saulrh/pcimotor/README.md

pcimotor
========

Microcontroller and driver code for a modular motor controller. The interesting thing is that this controller will fit into a PCI slot, so you can either plug it directly into your computer or into a special USB-interface backplane that we're also developing.
