saulrh/pcimotor/boards/daughterboard/pcie_board.brd

## EAGLE design boards/daughterboard/pcie_board.brd (2012-05-04)

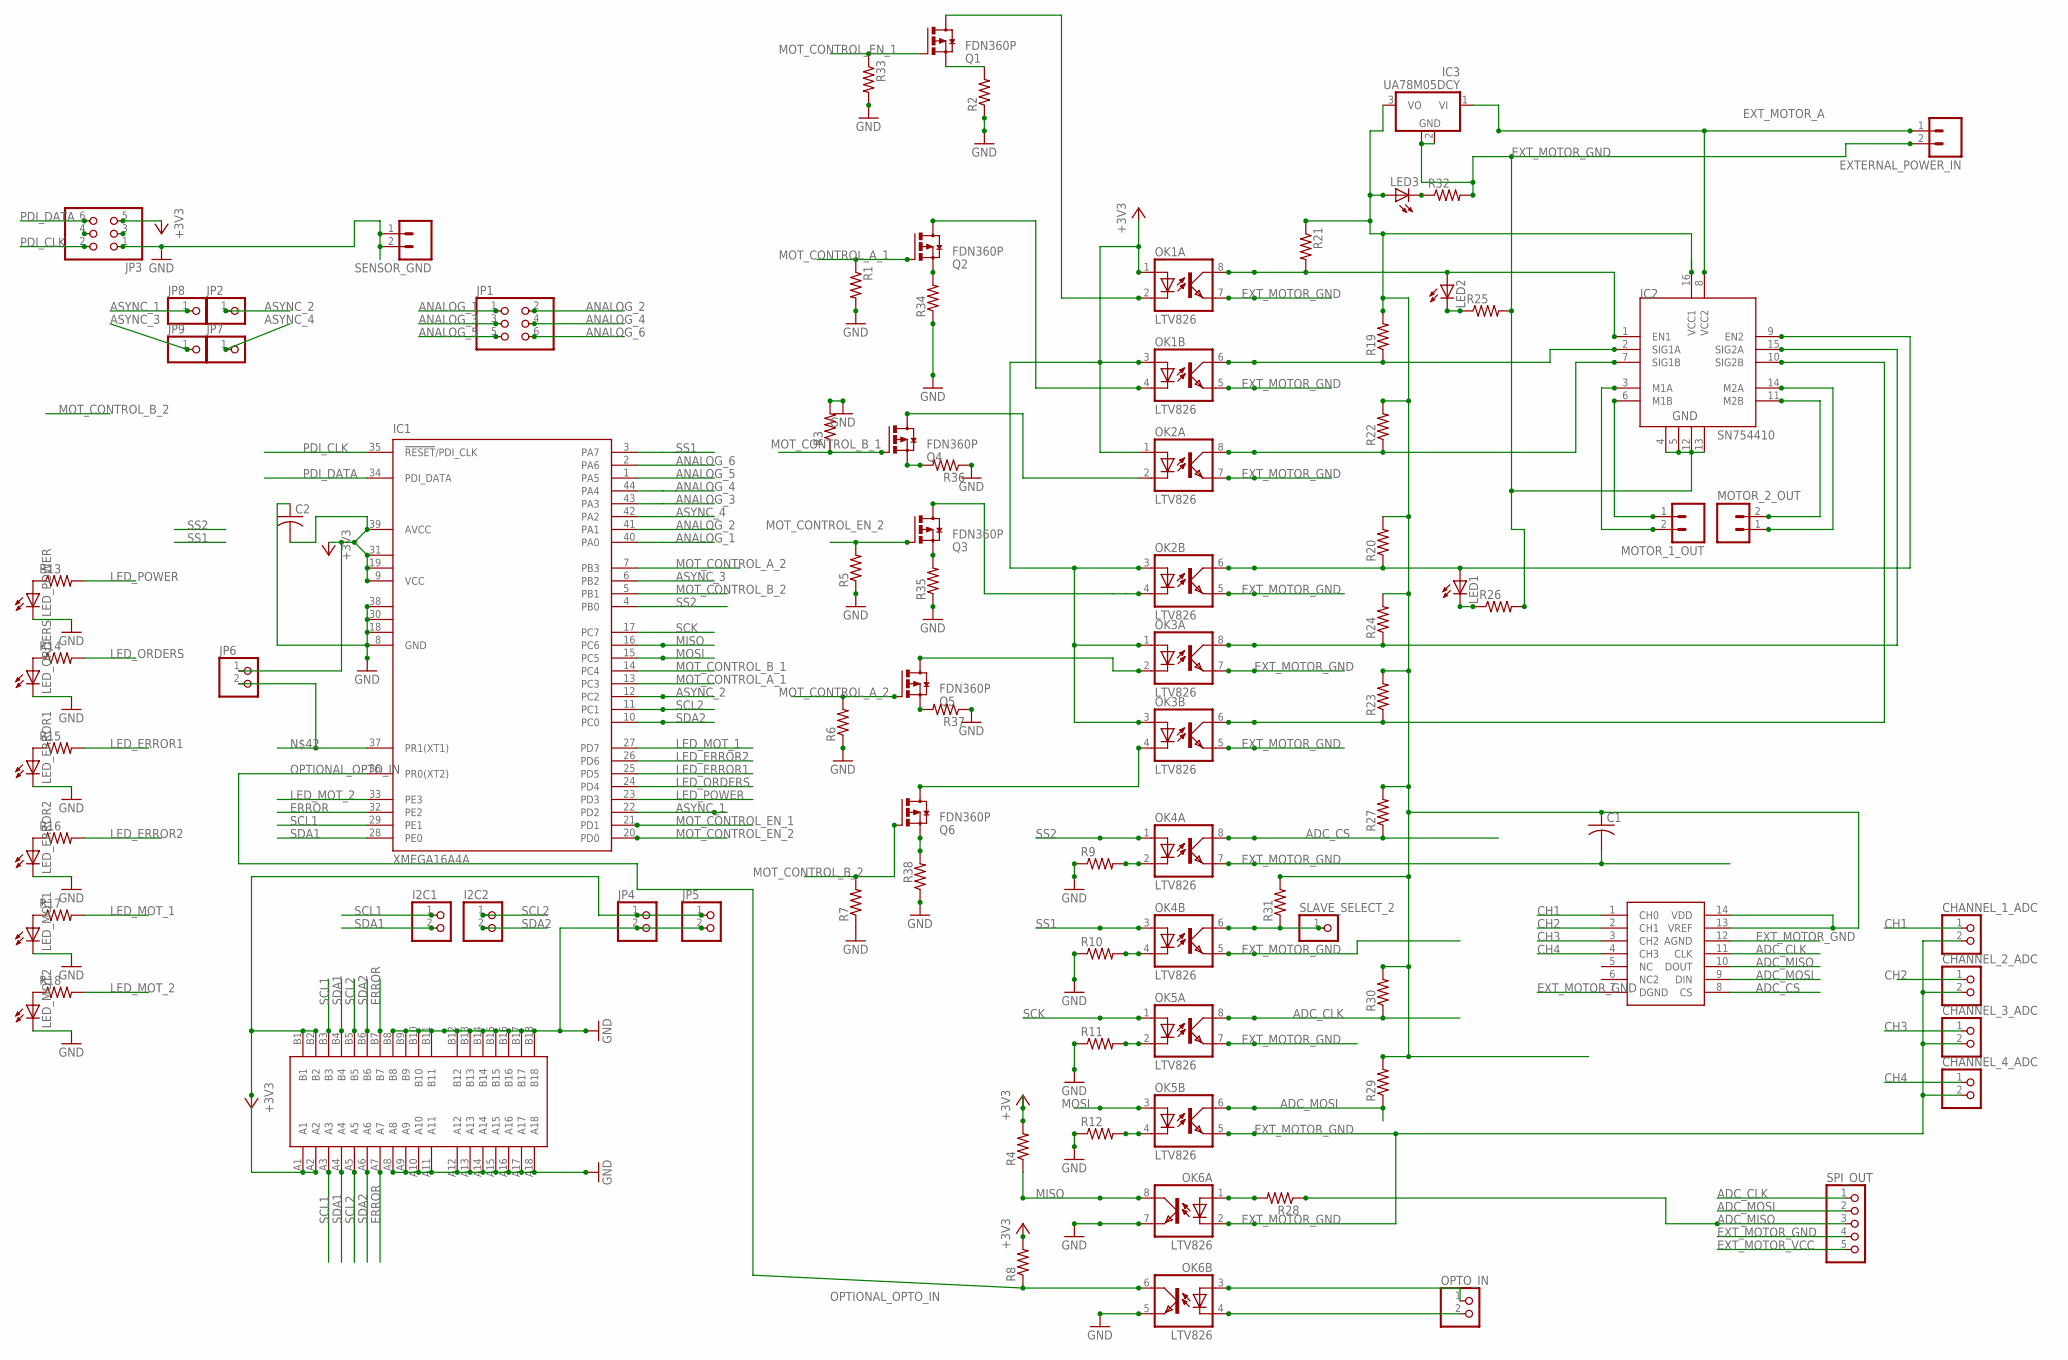
[picture p1: schematic pcie_board.sch, sheet 1]

Parts:
C1, C2: C-US025-040X050; C025-040X050
CHANNEL_1_ADC, CHANNEL_2_ADC, CHANNEL_3_ADC, CHANNEL_4_ADC: PINHD-1X2; 1X02
EXTERNAL_POWER_IN: M023.5MM; SCREWTERMINAL-3.5MM-2
I2C1, I2C2: PINHD-1X2; 1X02
IC1: XMEGA16A4A; TQFP44
IC2: SN754410; DIP16
IC3: UA78M05DCY; SOT223
JP1, JP3: PINHD-2X3; 2X03
JP2, JP7, JP8, JP9: PINHD-1X1; 1X01
JP4, JP5, JP6: PINHD-1X2; 1X02
LED1, LED2, LED3: LEDCHIP-LED0603; CHIP-LED0603
LED_ERROR1, LED_ERROR2: LED5MM
LED_MOT1, LED_MOT2: LED5MM
LED_ORDERS: LED5MM
LED_POWER: LED5MM
MOTOR_1_OUT, MOTOR_2_OUT: M023.5MM; SCREWTERMINAL-3.5MM-2
OK1, OK2, OK3, OK4, OK5, OK6: LTV826; DIL08
OPTO_IN: PINHD-1X2; 1X02
Q1, Q2, Q3, Q4, Q5, Q6: FDN360P; SUPER-SOT3
R1, R2, R3, R4, R5, R6, R7, R8, R9, R10, R11, R12, R13, R14, R15, R16, R17, R18, R19, R20, R21, R22, R23, R24, R25, R26, R27, R28, R29, R30, R31, R32, R33, R34, R35, R36, R37, R38: R-US_M0805; M0805
SENSOR_GND: M023.5MM; SCREWTERMINAL-3.5MM-2
SLAVE_SELECT_2: PINHD-1X1; 1X01
SPI_OUT: PINHD-1X5; 1X05
U$1: PCI-E1X_EDGE; PCI-E_X1_EDGE
U$2: MCP3004; DIL14

Connections:
+3V3: C2.2, IC1.9 (VCC), IC1.19 (VCC1), IC1.31 (VCC2), IC1.39 (AVCC), JP3.5, JP4.1, JP5.1, JP6.1, OK1.1 (A), OK1.3 (A), OK2.1 (A), OK2.3 (A), OK3.1 (A), OK3.3 (A), R4.2, R8.2, U$1.A1, U$1.A2, U$1.B1, U$1.B2
ADC_CLK: OK5.8 (COL), R30.1, SPI_OUT.1, U$2.11 (CLK)
ADC_CS: OK4.8 (COL), R27.1, U$2.8 (CS)
ADC_MISO: R28.1, SPI_OUT.3, U$2.10 (DOUT)
ADC_MOSI: OK5.6 (COL), R29.1, SPI_OUT.2, U$2.9 (DIN)
ANALOG_1: IC1.40 (PA0), JP1.1
ANALOG_2: IC1.41 (PA1), JP1.2
ANALOG_3: IC1.43 (PA3), JP1.3
ANALOG_4: IC1.44 (PA4), JP1.4
ANALOG_5: IC1.1 (PA5), JP1.5
ANALOG_6: IC1.2 (PA6), JP1.6
ASYNC_1: IC1.22 (PD2), JP8.1
ASYNC_2: IC1.12 (PC2), JP2.1
ASYNC_3: IC1.6 (PB2), JP9.1
ASYNC_4: IC1.42 (PA2), JP7.1
CH1: CHANNEL_1_ADC.1, U$2.1 (CH0)
CH2: CHANNEL_2_ADC.1, U$2.2 (CH1)
CH3: CHANNEL_3_ADC.1, U$2.3 (CH2)
CH4: CHANNEL_4_ADC.1, U$2.4 (CH3)
ERROR: IC1.32 (PE2), U$1.A7, U$1.B7
EXT_MOTOR_A: EXTERNAL_POWER_IN.1, IC2.8 (VCC2), IC3.1 (VI)
EXT_MOTOR_GND: C1.2, CHANNEL_1_ADC.2, CHANNEL_2_ADC.2, CHANNEL_3_ADC.2, CHANNEL_4_ADC.2, EXTERNAL_POWER_IN.2, IC2.4, IC2.5, IC2.12, IC2.13, IC3.2 (GND), IC3.4 (GND), OK1.5 (EMIT), OK1.7 (EMIT), OK2.5 (EMIT), OK2.7 (EMIT), OK3.5 (EMIT), OK3.7 (EMIT), OK4.5 (EMIT), OK4.7 (EMIT), OK5.5 (EMIT), OK5.7 (EMIT), OK6.2 (C), R25.2, R26.2, R32.2, SPI_OUT.4, U$2.7 (DGND), U$2.12 (AGND)
EXT_MOTOR_VCC: C1.1, IC2.16 (VCC1), IC3.3 (VO), LED3.A, R19.2, R20.2, R21.1, R22.2, R23.2, R24.2, R27.2, R29.2, R30.2, R31.2, SPI_OUT.5, U$2.13 (VREF), U$2.14 (VDD)
GND: C2.1, IC1.8 (GND), IC1.18 (GND1), IC1.30 (GND2), IC1.38 (GND3), JP3.1, JP4.2, JP5.2, LED_ERROR1.K (C), LED_ERROR2.K (C), LED_MOT1.K (C), LED_MOT2.K (C), LED_ORDERS.K (C), LED_POWER.K (C), OK6.5 (EMIT), OK6.7 (EMIT), R1.2, R2.1, R3.2, R5.1, R6.1, R7.1, R9.1, R10.1, R11.1, R12.1, R33.2, R34.1, R35.1, R36.1, R37.1, R38.1, SENSOR_GND.1, SENSOR_GND.2, U$1.A8, U$1.A9, U$1.A10, U$1.A11, U$1.A12, U$1.A13, U$1.A14, U$1.A15, U$1.A16, U$1.A17, U$1.A18, U$1.B8, U$1.B9, U$1.B10, U$1.B11, U$1.B12, U$1.B13, U$1.B14, U$1.B15, U$1.B16, U$1.B17, U$1.B18
LED_ERROR1: IC1.25 (PD5), R15.2
LED_ERROR2: IC1.26 (PD6), R16.2
LED_MOT_1: IC1.27 (PD7), R17.2
LED_MOT_2: IC1.33 (PE3), R18.2
LED_ORDERS: IC1.24 (PD4), R14.2
LED_POWER: IC1.23 (PD3), R13.2
MISO: IC1.16 (PC6), OK6.8 (COL), R4.1
MOSI: IC1.15 (PC5), OK5.3 (A)
MOT_CONTROL_A_1: IC1.13 (PC3), Q2.1 (G), R1.1
MOT_CONTROL_A_2: IC1.7 (PB3), Q5.1 (G), R6.2
MOT_CONTROL_B_1: IC1.14 (PC4), Q4.1 (G), R3.1
MOT_CONTROL_B_2: IC1.5 (PB1), Q6.1 (G), R7.2
MOT_CONTROL_EN_1: IC1.21 (PD1), Q1.1 (G), R33.1
MOT_CONTROL_EN_2: IC1.20 (PD0), Q3.1 (G), R5.2
unnamed: IC2.14 (M2A), MOTOR_2_OUT.1
unnamed: Q1.2 (S), R2.2
unnamed: IC2.11 (M2B), MOTOR_2_OUT.2
unnamed: OK1.2 (C), Q1.3 (D)
unnamed: Q2.2 (S), R34.2
unnamed: OK1.4 (C), Q2.3 (D)
unnamed: Q4.2 (S), R36.2
unnamed: OK4.2 (C), R9.2
unnamed: OK2.4 (C), Q3.3 (D)
unnamed: OK3.2 (C), Q5.3 (D)
unnamed: Q5.2 (S), R37.2
unnamed: OK4.4 (C), R10.2
unnamed: OK5.2 (C), R11.2
unnamed: OK5.4 (C), R12.2
unnamed: Q3.2 (S), R35.2
unnamed: LED_POWER.A, R13.1
unnamed: LED_ORDERS.A, R14.1
unnamed: OK2.2 (C), Q4.3 (D)
unnamed: OK4.6 (COL), R31.1, SLAVE_SELECT_2.1
unnamed: LED_ERROR1.A, R15.1
unnamed: LED_ERROR2.A, R16.1
unnamed: LED_MOT1.A, R17.1
unnamed: LED_MOT2.A, R18.1
unnamed: IC2.1 (EN1), LED2.A, OK1.8 (COL), R21.2
unnamed: IC2.2 (SIG1A), OK1.6 (COL), R19.1
unnamed: LED2.C, R25.1
unnamed: LED1.C, R26.1
unnamed: IC2.9 (EN2), LED1.A, OK2.6 (COL), R20.1
unnamed: IC2.7 (SIG1B), OK2.8 (COL), R22.1
unnamed: IC2.15 (SIG2A), OK3.8 (COL), R24.1
unnamed: IC2.3 (M1A), MOTOR_1_OUT.2
unnamed: IC2.6 (M1B), MOTOR_1_OUT.1
unnamed: IC2.10 (SIG2B), OK3.6 (COL), R23.1
unnamed: OK6.1 (A), R28.2
unnamed: OK6.3 (A), OPTO_IN.1
unnamed: OK6.4 (C), OPTO_IN.2
unnamed: LED3.C, R32.1
unnamed: Q6.2 (S), R38.2
unnamed: OK3.4 (C), Q6.3 (D)
unnamed: IC1.37 (PR1(XT1)), JP6.2
OPTIONAL_OPTO_IN: IC1.36 (PR0(XT2)), OK6.6 (COL), R8.1
PDI_CLK: IC1.35 (!RESET!/PDI_CLK), JP3.2
PDI_DATA: IC1.34 (PDI_DATA), JP3.6
SCK: IC1.17 (PC7), OK5.1 (A)
SCL1: I2C1.1, IC1.29 (PE1), U$1.A3, U$1.B3
SCL2: I2C2.1, IC1.11 (PC1), U$1.A5, U$1.B5
SDA1: I2C1.2, IC1.28 (PE0), U$1.A4, U$1.B4
SDA2: I2C2.2, IC1.10 (PC0), U$1.A6, U$1.B6
SS1: IC1.3 (PA7), OK4.3 (A)
SS2: IC1.4 (PB0), OK4.1 (A)

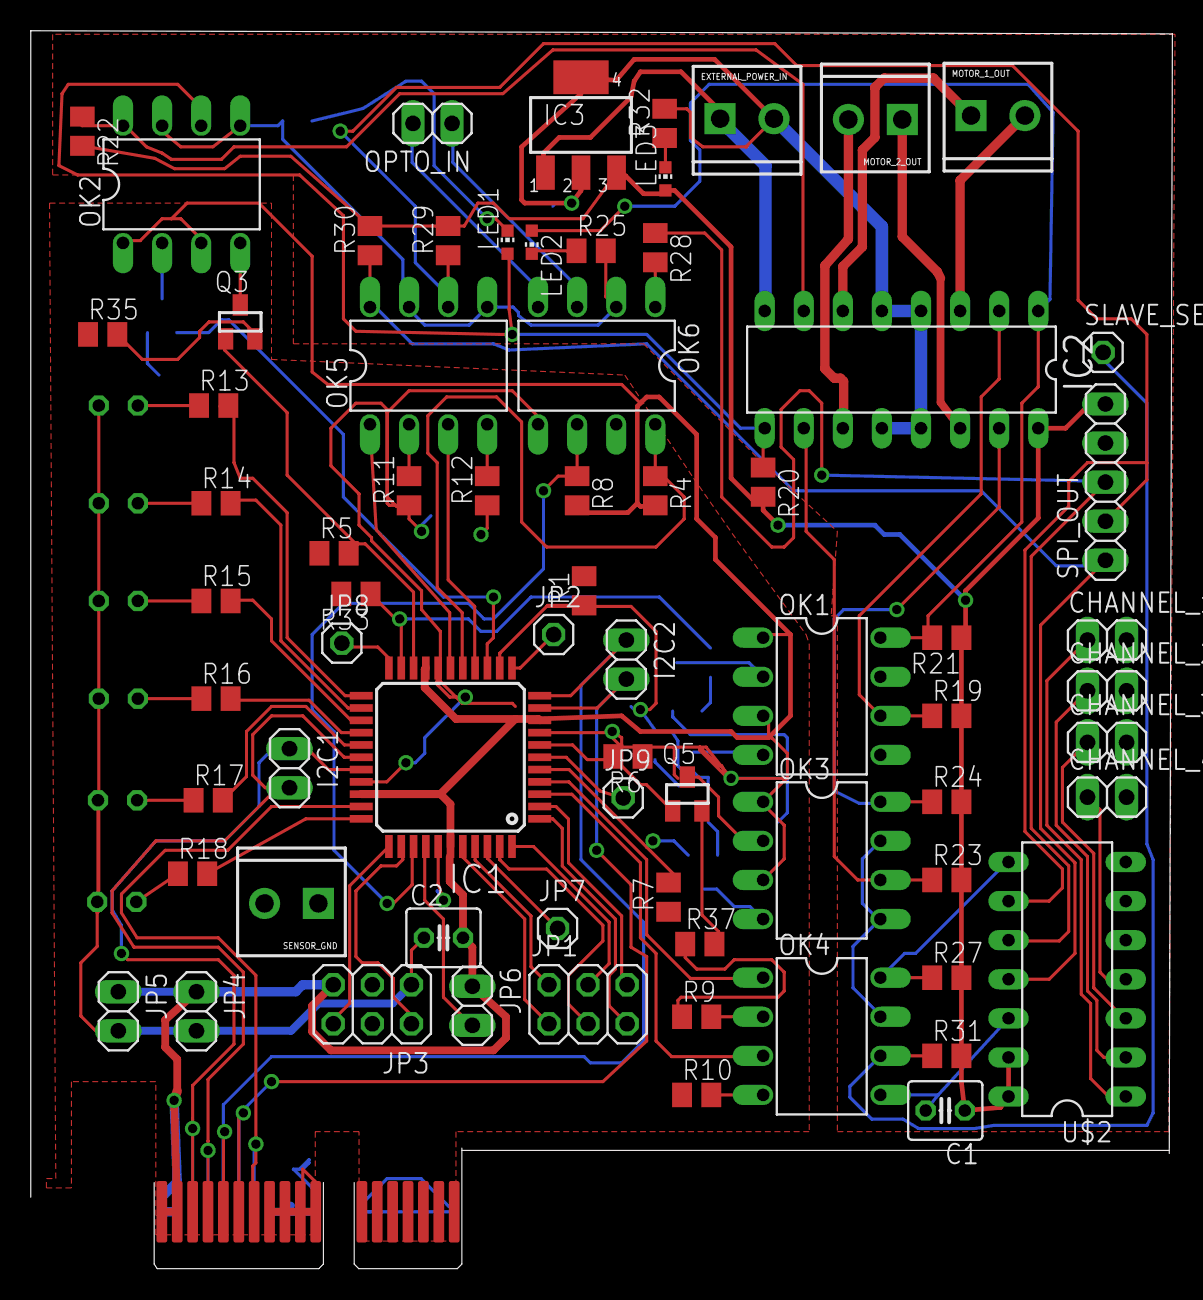
[picture p2: board pcie_board.brd from above]

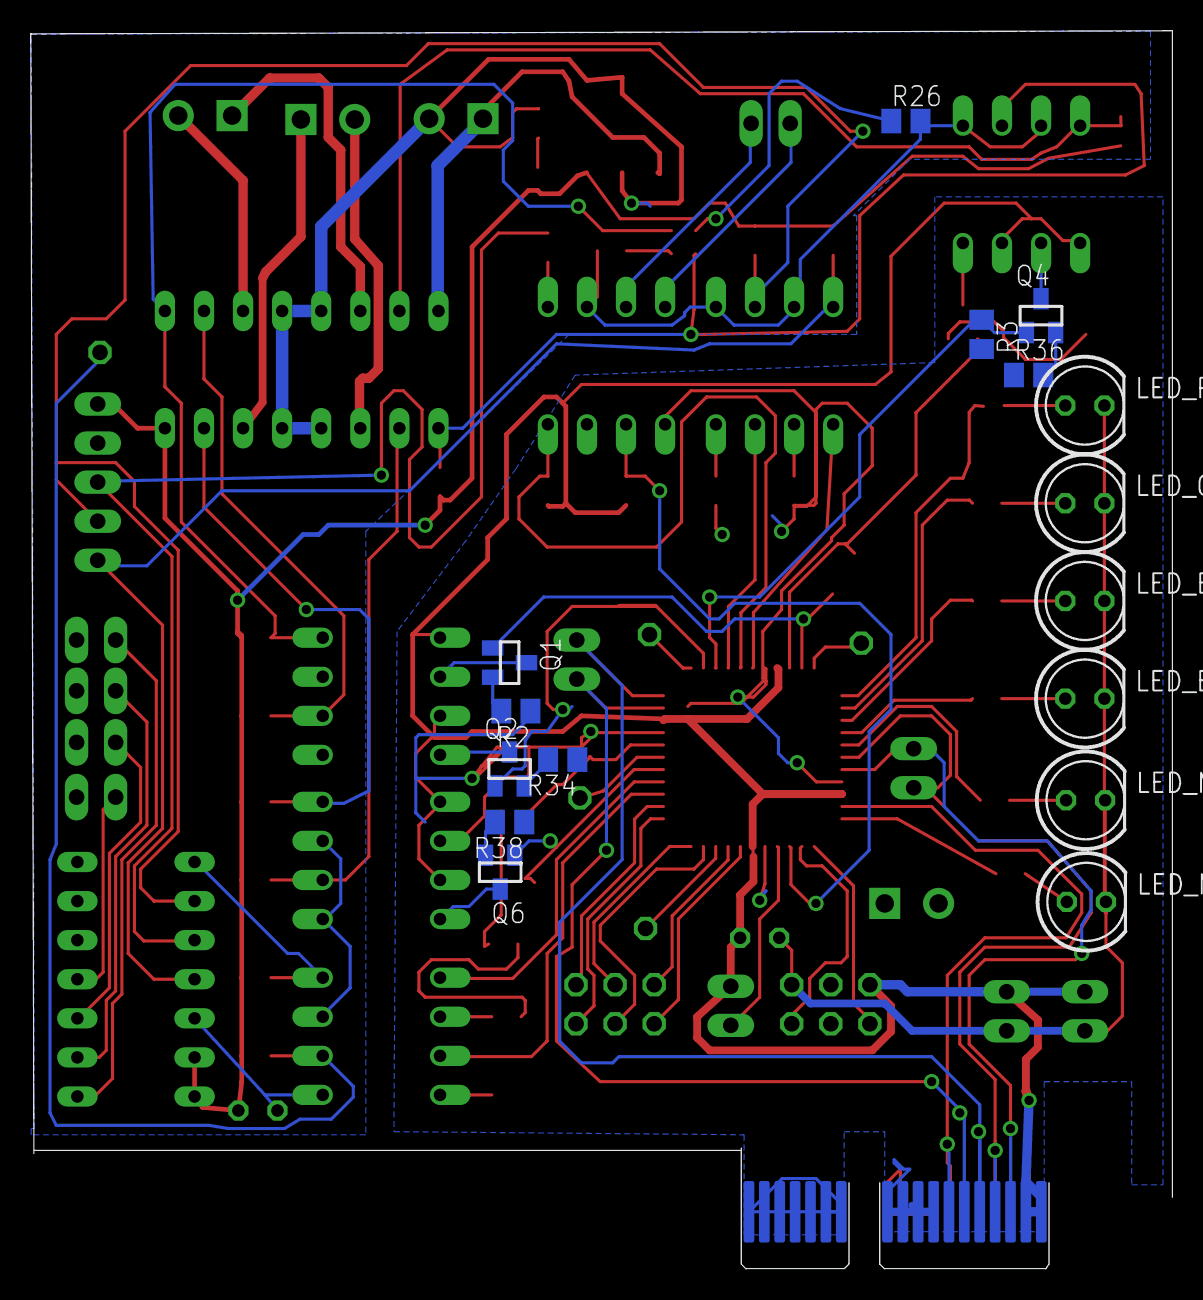
[picture p3: board pcie_board.brd from below]

Board: 2 copper layers, 74.2 x 80.5 mm, 88 parts (16 on the bottom side), 88 nets.
