saulrh/pcimotor/boards/motherboard/motherboard.brd

## EAGLE design boards/motherboard/motherboard.brd (2012-04-24)

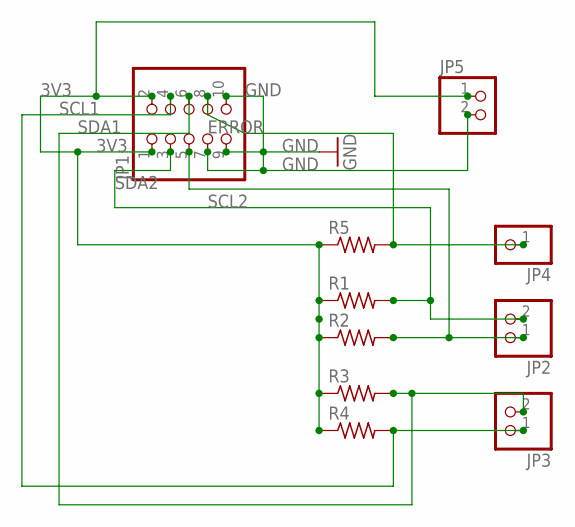
[picture p4: schematic motherboard.sch]

Parts:
JP1: PINHD-2X5; 2X05
JP2, JP3, JP5: PINHD-1X2; 1X02
JP4: PINHD-1X1; 1X01
R1, R2, R3, R4, R5: R-US_M0805; M0805

Connections:
3V3: JP1.1, JP1.2, JP5.1, R1.1, R2.1, R3.1, R4.1, R5.1
ERROR: JP1.8, JP4.1, R5.2
GND: JP1.7, JP1.9, JP1.10, JP5.2
SCL1: JP1.4, JP3.1, R4.2
SCL2: JP1.5, JP2.1, R2.2
SDA1: JP1.6, JP3.2, R3.2
SDA2: JP1.3, JP2.2, R1.2

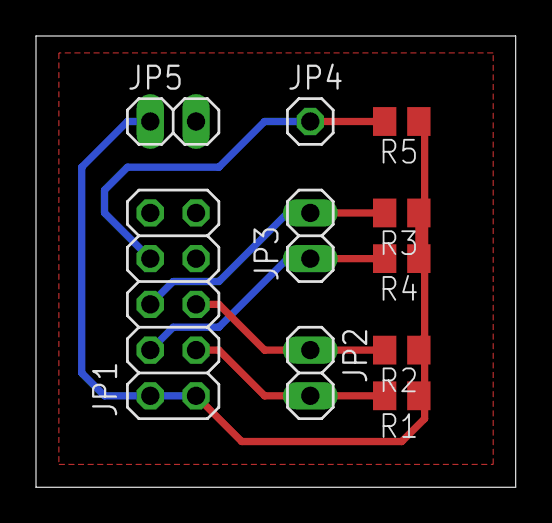
[picture p5: board motherboard.brd from above]

Board: 2 copper layers, 26.7 x 25.1 mm, 10 parts (0 on the bottom side), 7 nets.
