saulrh/pcimotor/boards/satellite_board/satellite.brd

## EAGLE design boards/satellite_board/satellite.brd (2012-04-24)

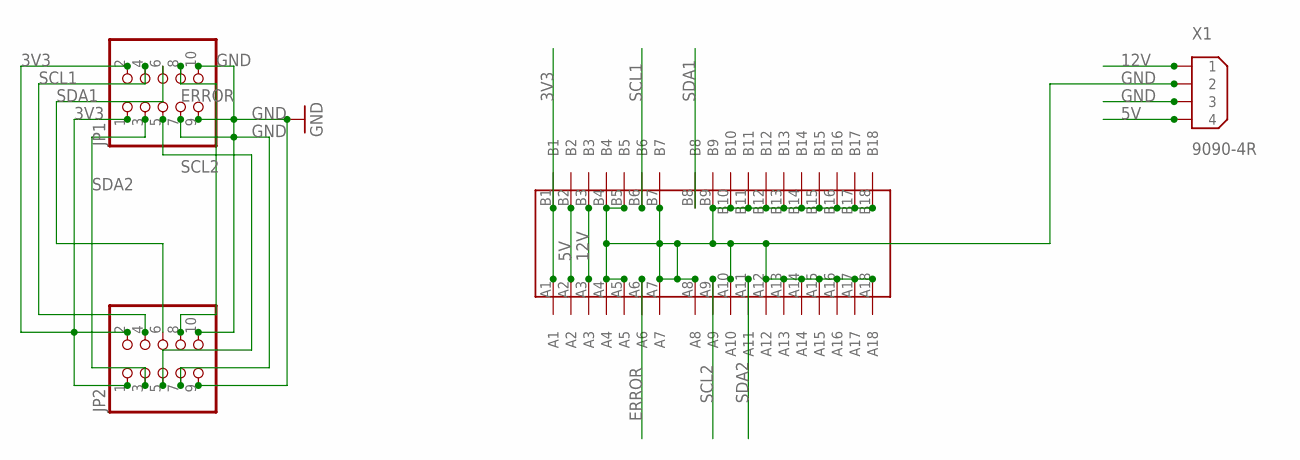
[picture p6: schematic satellite.sch]

Parts:
JP1, JP2: PINHD-2X5; 2X05
U$1: PCIE1X
X1: 9090-4R

Connections:
3V3: JP1.1, JP1.2, JP2.1, JP2.2, U$1.A1, U$1.B1
5V: U$1.A2, U$1.B2, X1.4
12V: U$1.A3, U$1.B3, X1.1
ERROR: JP1.8, JP2.8, U$1.A6
GND: JP1.7, JP1.9, JP1.10, JP2.7, JP2.9, JP2.10, U$1.A4, U$1.A5, U$1.A7, U$1.A8, U$1.A10, U$1.A12, U$1.A13, U$1.A14, U$1.A15, U$1.A16, U$1.A17, U$1.A18, U$1.B4, U$1.B5, U$1.B7, U$1.B9, U$1.B10, U$1.B11, U$1.B12, U$1.B13, U$1.B14, U$1.B15, U$1.B16, U$1.B17, U$1.B18, X1.2, X1.3
SCL1: JP1.4, JP2.4, U$1.B6
SCL2: JP1.5, JP2.5, U$1.A9
SDA1: JP1.6, JP2.6, U$1.B8
SDA2: JP1.3, JP2.3, U$1.A11

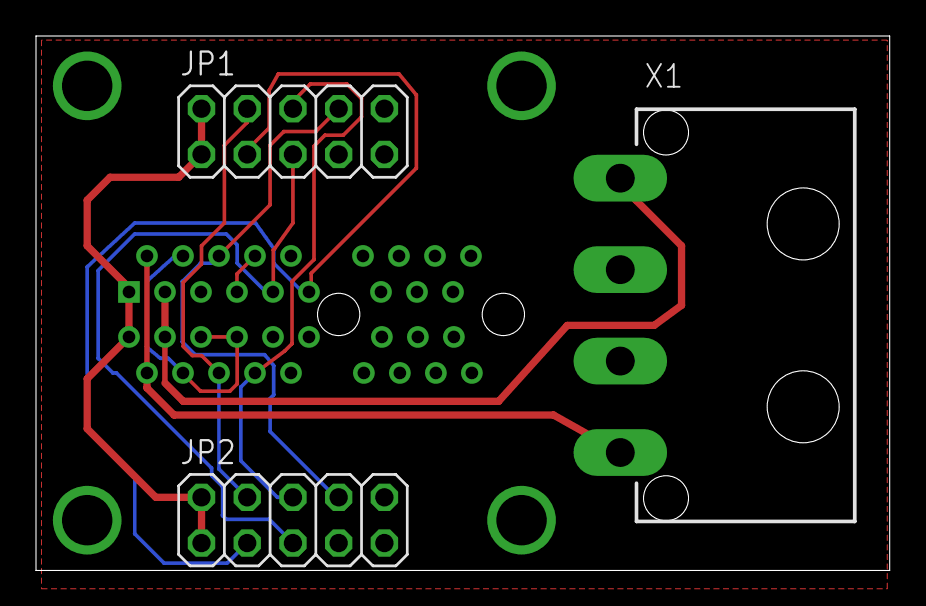
[picture p7: board satellite.brd from above]

Board: 2 copper layers, 47.4 x 29.7 mm, 4 parts (0 on the bottom side), 9 nets.
