saulrh/pcimotor/avr/avr_compiler.h

/* This file has been prepared for Doxygen automatic documentation generation.*/
/*! \file *********************************************************************
 *
 * \brief This file implements some macros that makes the IAR C-compiler and
 *        avr-gcc work with the same code base for the AVR architecture.
 *
 * \par Documentation
 *      For comprehensive code documentation, supported compilers, compiler
 *      settings and supported devices see readme.html
 *
 * \author
 *      Atmel Corporation: http://www.atmel.com \n
 *      Support email: avr@atmel.com
 *
 * $Revision: 2772 $
 * $Date: 2009-09-11 12:40:26 +0200 (fr, 11 sep 2009) $  \n
 *
 * Copyright (c) 2008, Atmel Corporation All rights reserved.
 *
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
 * 3. The name of ATMEL may not be used to endorse or promote products derived
 * from this software without specific prior written permission.
 *
 * THIS SOFTWARE IS PROVIDED BY ATMEL "AS IS" AND ANY EXPRESS OR IMPLIED
 * WARRANTIES, INCLUDING, BUT NOT LIMITED TO, THE IMPLIED WARRANTIES OF
 * MERCHANTABILITY AND FITNESS FOR A PARTICULAR PURPOSE ARE EXPRESSLY AND
 * SPECIFICALLY DISCLAIMED. IN NO EVENT SHALL ATMEL BE LIABLE FOR ANY DIRECT,
 * INDIRECT, INCIDENTAL, SPECIAL, EXEMPLARY, OR CONSEQUENTIAL DAMAGES
 * (INCLUDING, BUT NOT LIMITED TO, PROCUREMENT OF SUBSTITUTE GOODS OR SERVICES;
 * LOSS OF USE, DATA, OR PROFITS; OR BUSINESS INTERRUPTION) HOWEVER CAUSED AND
 * ON ANY THEORY OF LIABILITY, WHETHER IN CONTRACT, STRICT LIABILITY, OR TORT
 * (INCLUDING NEGLIGENCE OR OTHERWISE) ARISING IN ANY WAY OUT OF THE USE OF
 * THIS SOFTWARE, EVEN IF ADVISED OF THE POSSIBILITY OF SUCH DAMAGE.
 ******************************************************************************/

#ifndef COMPILER_AVR_H
#define COMPILER_AVR_H

#ifndef F_CPU
/*! \brief Define default CPU frequency, if this is not already defined. */
#define F_CPU 2000000UL
#endif

#include <stdint.h>
#include <stdbool.h>
#include <stdlib.h>

/*! \brief This macro will protect the following code from interrupts. */
#define AVR_ENTER_CRITICAL_REGION( ) uint8_t volatile saved_sreg = SREG; \
                                     cli();

/*! \brief This macro must always be used in conjunction with AVR_ENTER_CRITICAL_REGION
 *        so the interrupts are enabled again.
 */
#define AVR_LEAVE_CRITICAL_REGION( ) SREG = saved_sreg;






#include <avr/io.h>
#include <avr/interrupt.h>
#include <avr/pgmspace.h>
#include <util/delay.h>

/*! \brief Define the delay_us macro for GCC. */
#define delay_us( us )   (_delay_us( us ))

#define INLINE static inline

/*! \brief Define the no operation macro. */
#define nop()   do { __asm__ __volatile__ ("nop"); } while (0)

#define MAIN_TASK_PROLOGUE int


#define MAIN_TASK_EPILOGUE() return -1;

#define SHORTENUM __attribute__ ((packed))

#endif
