saulrh/pcimotor/(commit log)

2012-04-16 Accidentally left a hanging define. fixed.
    [daughterboard.c]
2012-04-20 make the LEDs flash faster
2012-04-20 Add daughterboard.h for function prototypes
2012-04-21 fixed bug in pin definitions
    [daughterboard.h]
2012-04-21 use symbolic pin name declarations and multipin config
2012-04-21 display received twi data on leds
2012-04-21 change to I2C interface 2
2012-04-21 start up summary of i2c command protocol
2012-04-23 Fixed includes in daughterboard.c for movements.
    [daughterboard.c]
2012-04-23 New code for handling LEDs
2012-04-23 Rough draft of I2C interface
2012-04-23 daughterboard.h: Fixed typedefs for sensor_t
    [daughterboard.h]
2012-04-23 Reorganize so we can add drivers and boards later
2012-04-23 added the board design files
    [board_with_sense.brd, board_with_sense.sch]
2012-04-23 reorganized the boards into folders
    [board_with_sense.brd, board_with_sense.sch]
2012-04-23 Removed duplicate files. Use tags for marking revs
    [board_with_sense.brd, board_with_sense.sch]
2012-04-24 moved stuff around to allow for more boards
    [pcie_board.brd, pcie_board.sch]
2012-04-24 added the eagle libraries, as well as the satellite board
    [satellite.brd, satellite.sch]
2012-04-24 added the interface board to talk to the ribbon cable of the satellite board
    [satellite_interface.brd, satellite_interface.sch]
2012-04-24 Rename boards to standardized names
    [motherboard.brd, motherboard.sch, pcie_board.brd, pcie_board.sch]
2012-04-27 daughterboard: Define structs for motors and controller
2012-04-27 daughterboard: start changing over to hardware pwm
2012-04-28 fixed the timer from port C to port D
    [daughterboard.c]
2012-04-28 fixing random bugs - working toward motor pwm
    [daughterboard.c]
2012-04-28 Add driver for watchdog timer
2012-04-28 Link in code for watchdog timer
2012-04-28 daughterboard.h: Fix definitions for digital pins
    [daughterboard.h]
2012-04-28 daughterboard.c: include watchdog timer
2012-04-28 daughterboard.c: set and handle watchdog timer
2012-04-28 Start changing LEDs over to malloc's structs
2012-04-28 Finish converting leds to malloc'd structs
2012-04-28 Set up clock for PWMing the motor ouputs
2012-04-29 Functional i2c - displays received data on digout
2012-04-29 Tweak i2c initialization
2012-04-29 Fix up motor duty cycle - simple version
    [daughterboard.c]
2012-04-29 Flash LEDs when motor is on
2012-04-29 Use motor b instead of motor A so we have an LED.
2012-04-29 Added an i2c header file defining the commands
2012-04-30 added the switch statement, as well as the get all data function
2012-05-02 i2c commands: turns out that avr has 32-bit floats
2012-05-02 daughterboard: can control two motors!
2012-05-03 Latest board(the one presented at class
    [pcie_board.brd, pcie_board.sch]
2012-05-04 added some fets to take care of the overloaded atxmega.
    [pcie_board.brd, pcie_board.sch]
